Kinoma/Kinoma-Element-Open-source-hardware-1st-Generation/README.md

# Kinoma Element

This repository contains open source hardware resources for Kinoma Element.

The application framework software for Kinoma Element is in the [kinomajs](https://github.com/Kinoma/kinomajs) repository .

Including:

* BOM
* PCB Design files
* PCB Schematics
* STEP files for case
