Kinoma/Kinoma-Element-Open-source-hardware-1st-Generation/bom/Element-dvt-Nov30.xlsx

Kinoma Element Revised: Wednesday, November 25, 2015
Kinoma Element DVT2 Revision: 1
Bill Of Materials November 25,2015 13:31:08
Item | Quantity | Reference | Part | Vendor | Part Number | Description | Notes
______________________________________________
1 | 1 | ANT1 | 2450AT18A100 | johanson | 2450AT18A100 | Chip Antenna 3.2 x 1.6 x 1.3mm | DO NOT SUBSTITUTE
2 | 1 | CM1 | CMC_2L_60R_600mA | Wurth | 7442335600 | CHOKE COM MODE 60R,600mA | DO NOT SUBSTITUTE
3 | 1 | CM2 | CMC_3L | TDK | ACM2520-801-3P-T002 | CHOKE COMMON MODE 800 OHM SMD | DO NOT SUBSTITUTE
4 | 5 | C1,C2,C16,C85,C90 | 2.2uF | TDK | C1005X5R1A225K050BC | CAP CER 2.2UF 10V 10% X5R 0402
5 | 21 | C3,C6,C7,C8,C9,C10,C13,C14,C24,C27,C28,C29,C48,C86,C87,C88,C89,C92,C93,C94,C96 | 0.1uF | murata | GRM033R60J104KE19D | CAP CER 0.1UF 6.3V 10% X5R 0201
6 | 8 | C4,C19,C21,C22,C23,C25,C26,C98 | 0.01uF | murata | GRM033R71A103KA01D | CAP CER 10000PF 10V 10% X7R 0201
7 | 3 | C5,C15,C17 | 10uF 6.3V X5R | tdk | C1005X5R0J106M050BC | CAP CER 10UF 6.3V 20% X5R 0402
8 | 1 | C12 | 10pF RF | johanson | 250R05L100GV4T | CAP CER 10PF 25V 2% NP0 0201 | DO NOT SUBSTITUTE
9 | 2 | C18,C20 | 1.0uF | tdk | C0603X5R0J105M030BC | CAP CER 1UF 6.3V 20% X5R 0201
10 | 1 | C49 | 10uF 10V X6S | murata | GRM188C81A106MA73D | CAP CER 10UF 10V 20% X6S 0603
11 | 1 | C50 | 4.7uF | Taiyo | LMK107BJ475KA-T | CAP CER 4.7UF 10V 10% X5R 0603
12 | 1 | C51 | 10uF 6.3V X5R | tdk | C1608X5R0J106K080AB | CAP CER 10UF 6.3V 10% X5R 0603
13 | 1 | D10 | DIODE_LED_RGB_RA | sunled | XZMDKDGCBD56W | LED 3.0X1.0MM RGB WTR CLR RA SMD
14 | 6 | FB1,FB2,FB7,FB8,FB9,FB10 | FB/3A | Wurth Electronics | 742792602 | WE-CBF SMD EMI SUPP FERRITE BEAD
15 | 1 | FL1 | LFB182G45CL3D178 | murata | LFB182G45CL3D178 | FILTER BANDPASS 2.4 GHZ | DO NOT SUBSTITUTE
16 | 1 | J1 | CON8A | sullin | GRPB042VWQP-RC | CONN HEADER .050" 8POS DL SMD AU | For development use ONLY
17 | 1 | J3 | USB MICRO-AB RCPT | molex | 475901001 | Connector Receptacle USB micro AB 5 Position Surface Mount, Right Angle, Horizontal
 |  |  |  | Hirose | ZX62RD-AB-5P8 | possible substitutes for line # 17
18 | 2 | J6,J9 | HDR1x8 | Gradconn | BB02-JS082.-K03-000000 | Connector Header 8 Position 0.100" (2.54mm) Tin SMD, Right Angle
19 | 2 | L1,L5 | 2.2nH | Johanson | L-07C2N2SV6T | FIXED IND 2.2NH 300MA 160 MOHM | DO NOT SUBSTITUTE
20 | 1 | L3 | 2.2uH | taiyo | BRC2012T2R2MD | FIXED IND 2.2UH 1A 143 MOHM SMD
21 | 1 | L4 | 2.2uH | sumida | CDRH2D14NP-2R2NC | FIXED IND 2.2UH 1.6A 94 MOHM SMD
22 | 2 | MOV1,MOV3 | CDS305GTA | Epcos | B72500D50A60 | VARISTOR 6.4V 30A 0603
 |  |  |  | Wurth | 82536040 | possible substitutes for line # 22,
 |  |  |  | Bourns | CG0603MLA-5.5ME
 |  |  |  | Eaton | MLVA06V05C270
23 | 16 | Q1,Q2,Q3,Q4,Q5,Q6,Q7,Q8,Q9,Q10,Q11,Q12,Q13,Q14,Q15,Q16 | FDY4000CZ | Fairchild | FDY4000CZ | MOSFET N/P-CH 20V SC89-6 | DO NOT SUBSTITUTE
24 | 1 | R3 | 6.04k 1% | panasonic | ERJ-1GEF6041C | RES SMD 6.04K OHM 1% 1/20W 0201
25 | 4 | R4,R5,R6,R7 | 51K | panasonic | ERJ-1GEJ513C | RES SMD 51K OHM 5% 1/20W 0201
26 | 1 | R25 | 1k | panasonic | ERJ-1GEJ102C | RES SMD 1K OHM 5% 1/20W 0201
27 | 41 | R27,R28,R29,R30,R36,R63,R84,R85,R86,R87,R88,R89,R90,R91,R92,R93,R94,R95,R96,R97,R98,R99,R100,R101,R102,R103,R104,R105,R106,R107,R108,R109,R110,R111,R112,R113,R114,R115,R116,R117,R121 | 10K | Panasonic | ERJ-1GEJ103C | RES 10K OHM 1/20W 5% 0201 SMD
28 | 3 | R48,R49,R118 | 330R | panasonic | ERJ-1GEJ331C | RES SMD 330 OHM 5% 1/20W 0201
29 | 1 | R54 | 2.2K | panasonic | ERJ-1GEJ222C | RES SMD 2.2K OHM 5% 1/20W 0201
30 | 1 | R60 | 0R | Panasonic | ERJ-3GEY0R00V | RES 0.0 OHM 1/10W 0603 SMD
31 | 1 | R64 | 453K | Panasonic | ERJ-1GEF4533C | RES SMD 453K OHM 1% 1/20W 0201
32 | 1 | R65 | 100K | Panasonic | ERJ-1GEF1003C | RES SMD 100K OHM 1% 1/20W 0201
33 | 2 | R119,R120 | 100R | panasonic | ERJ-1GEJ101C | RES SMD 100 OHM 5% 1/20W 0201
34 | 1 | R128 | 22R | panasonic | ERJ-1GEF22R0C | RES SMD 22 OHM 1% 1/20W 0201
35 | 2 | S1,S2 | SW_PB_RA_4P | wurth | 434331045822 | SWITCH TACTILE SPST-NO 0.05A 12V | consigned
36 | 1 | U1 | 88MW302QFN88 | marvell | 88MW302QFN88 | IC MRVL 88MW302 WLAN MICROCONTROLLER SoC QFN88L 0.4mm 10x10x0.9mm | consigned
37 | 1 | U2 | W25Q32FVZPIG | winbond | W25Q32FVZPIG | IC SPI SRL FLASH DUAL/QUAD I/O 32M 2.7-3.6V 104MHZ WSON-8 6x5x0.8mm | DO NOT SUBSTITUTE
38 | 1 | U7 | AP3417C | Diodes | AP3417CKTR-G1 | IC REG BUCK SYNC ADJ 1A SOT25
39 | 1 | U8 | IP4220CZ6 | nxp | IP4220CZ6,125 | IC USB DUAL ESD PROTECT 6TSOP | DO NOT SUBSTITUTE
40 | 4 | U13,U14,U17,U18 | 74HC4094 | NXP | 74HC4094PW,118 | IC 8STAGE SHFT/STORE BUS 16TSSOP
 |  |  |  | TI | CD4094BPWR | Possble substitutes for line # 40
 |  |  |  | Rohm | BU4094BCFV-E2
 |  |  |  | On Semiconductor | MC14094BDTR2G
 |  |  |  | ST microelectronics | M74HC4094TTR
41 | 4 | U15,U16,U19,U20 | D5V0F4U6SO-7 | Diodes | D5V0F4U6SO-7 | TVS DIODE 5.5VWM 12VC SOT26
42 | 1 | Y1 | 38.4MHz +/-10ppm | txc | 8Q38470003 | Crystal 38.4000MHz 10ppm 8pF 80 Ohm -20°C - 70°C Surface Mount 4-SMD, No Lead (DFN, LCC) | DO NOT SUBSTITUTE
43 | 1 | Y2 | 32.768KHz_3.3V_+/-25ppm | txc | 7XZ3270018 | OSC XO 32.768KHZ CMOS SMD | DO NOT SUBSTITUTE
Unpopulated Parts
44 | 2 | C84,C91 | *2.2uF | TDK | C1005X5R1A225K | CAP CER 2.2UF 10V 10% X5R 0402
45 | 1 | C95 | *0.1uF | murata | GRM033R60J104KE19D | CAP CER 0.1UF 6.3V 10% X5R 0201
46 | 1 | J2 | *3PIN | fci | 68000-103HLF | BERGSTIK II .100" SR STRAIGHT
47 | 1 | J11 | *CON2 | sullin | GRPB021VWVN-RC | CONN HEADER .050" 2POS PCB GOLD
48 | 1 | L2 | *2.2nH | Johanson | L-07C2N2SV6T | FIXED IND 2.2NH 300MA 160 MOHM
49 | 7 | TP1,TP2,TP3,TP4,TP5,TP6,TP7 | *T_POINT | Test | NA | SMT Test Point
