Kinoma/Kinoma-Element-Open-source-hardware-1st-Generation/sch/element-dvt-Nov30.pdf

# 2.4GHz Wifi Antenna

# GPIO

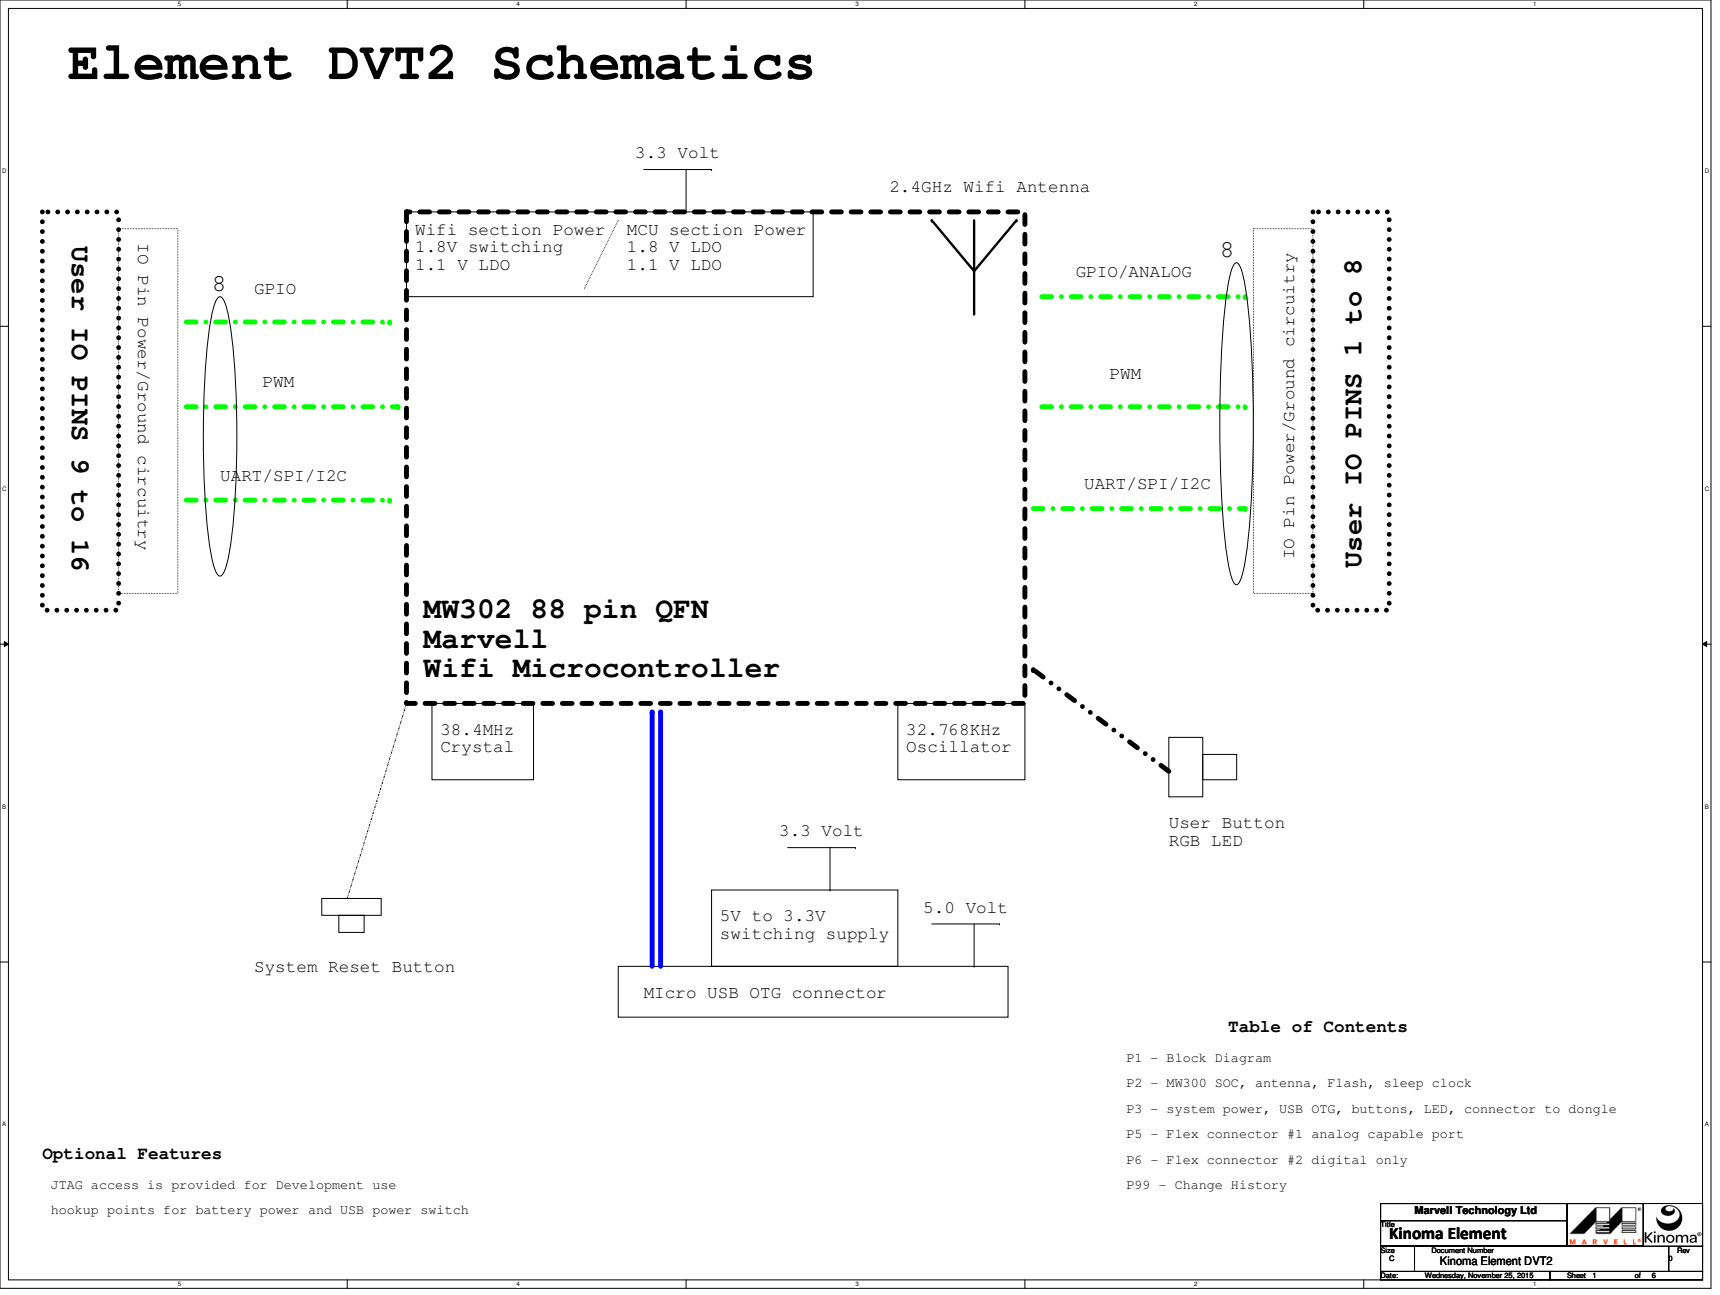
[picture p2: page 1]
P1 - Block Diagram; Optional Features; P6 - Flex connector #2 digital only; P99 - Change History; 5V to 3.3V switching supply; 38.4MHz Crystal; 32.768KHz Oscillator; 3.3 Volt; User Button RGB LED; PWM; UART/SPI/I2C; GPIO/ANALOG; MW302 88 pin QFN Marvell Wifi Microcontroller; 5.0 Volt; Element DVT2 Schematics; Title; Size; Document Number; Rev; Date:; Sheet; Kinoma Element DVT2; Wednesday, November 25, 2015; Kinoma Element

Wifi section Power
1.8V switching
1.1 V LDO

MCU section Power
1.8 V LDO

User IO PINS 9 to 16

IO Pin Power/Ground circuitry

User IO PINS 1 to 8

System Reset Button

MIcro USB OTG connector

Table of Contents

P2 - MW300 SOC, antenna, Flash, sleep clock

P3 - system power, USB OTG, buttons, LED, connector to dongle

P5 - Flex connector #1 analog capable port

JTAG access is provided for Development use

hookup points for battery power and USB power switch

Marvell Technology Ltd
Kinoma Element

# 88MW302 QFN-88 SoC Circuit

# STRAP1 not used

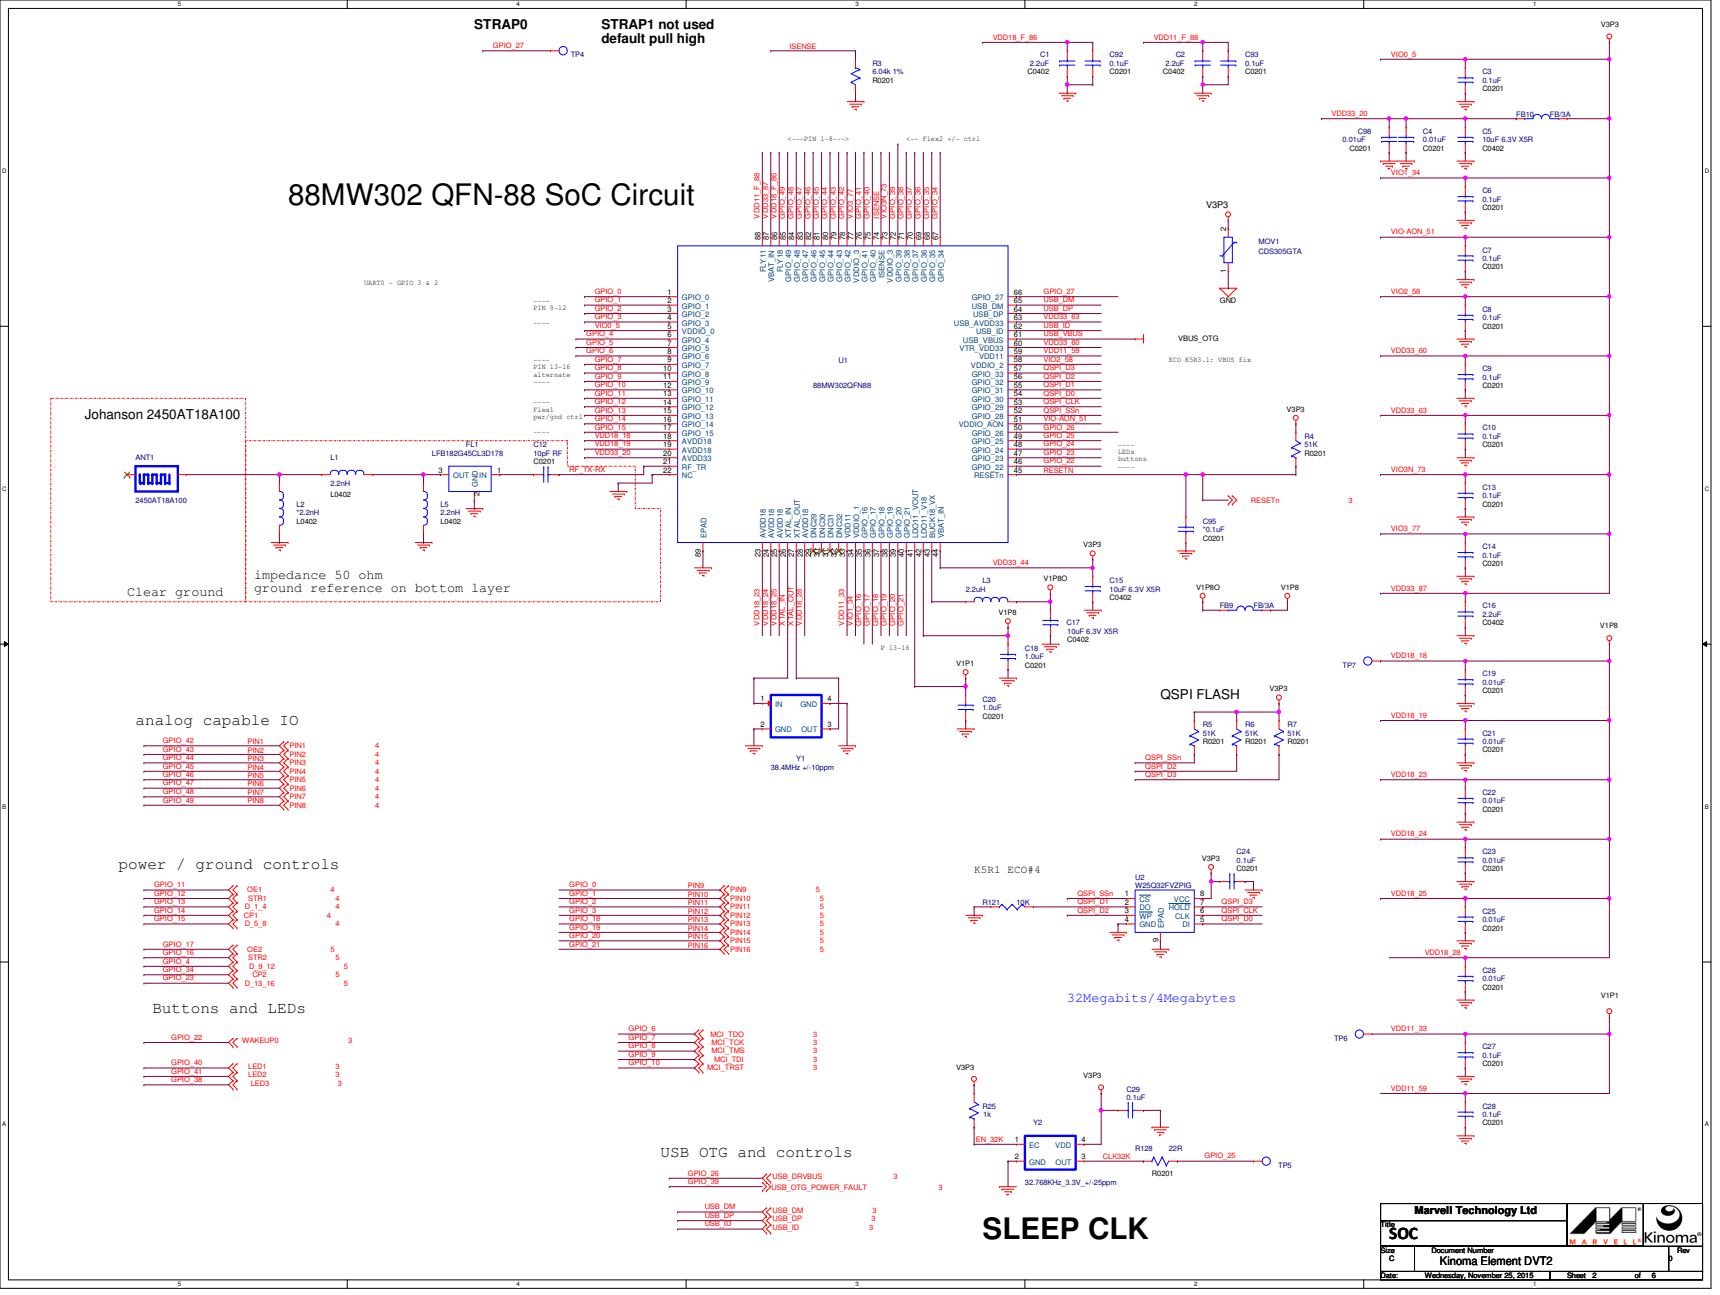
[picture p3: page 2]

impedance 50 ohm
ground reference on bottom layer

# FTDI, USB OTG JTAG on dongle for development

# Battery Hookup

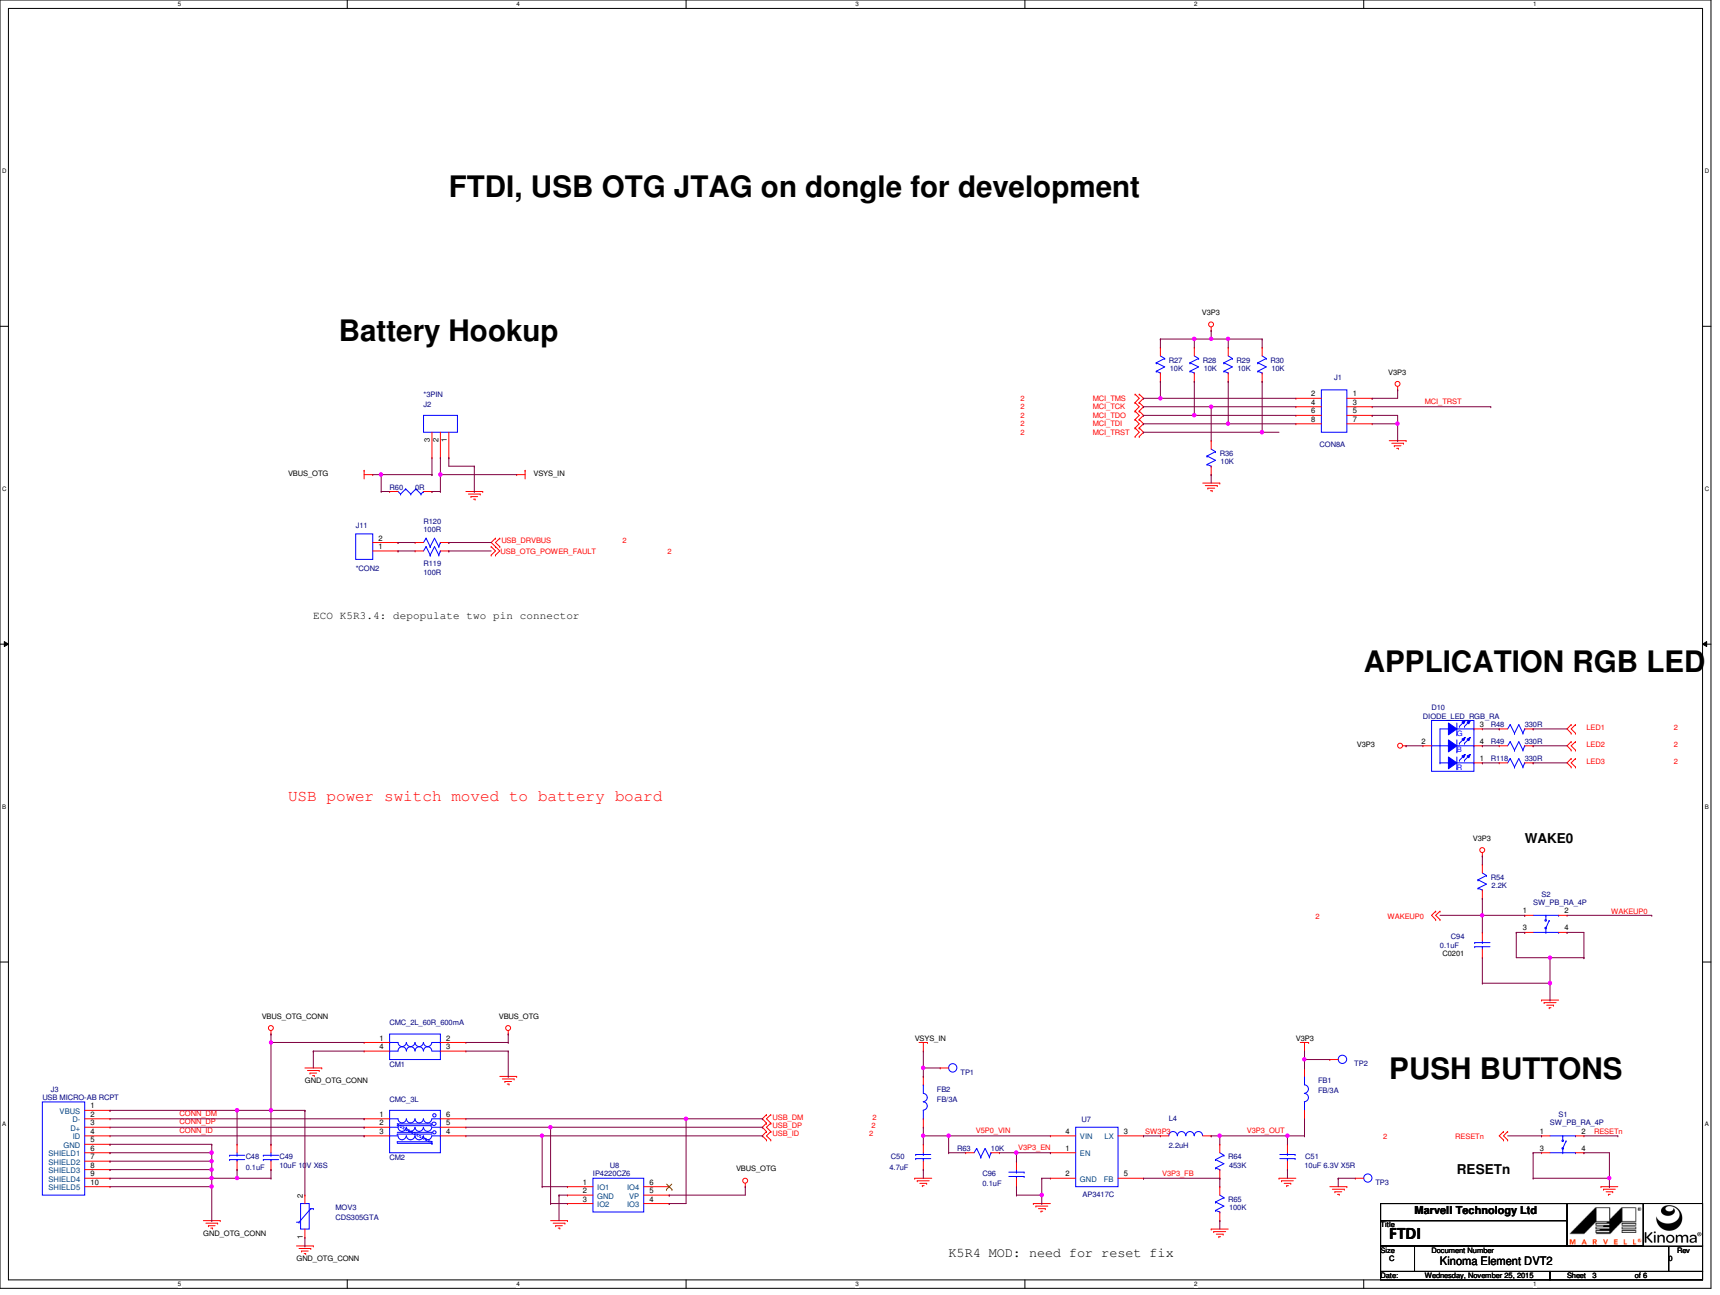
[picture p4: page 3]

ECO K5R3.4: depopulate two pin connector

USB power switch moved to battery board

USB MICRO-AB RCPT

K5R4 MOD: need for reset fix

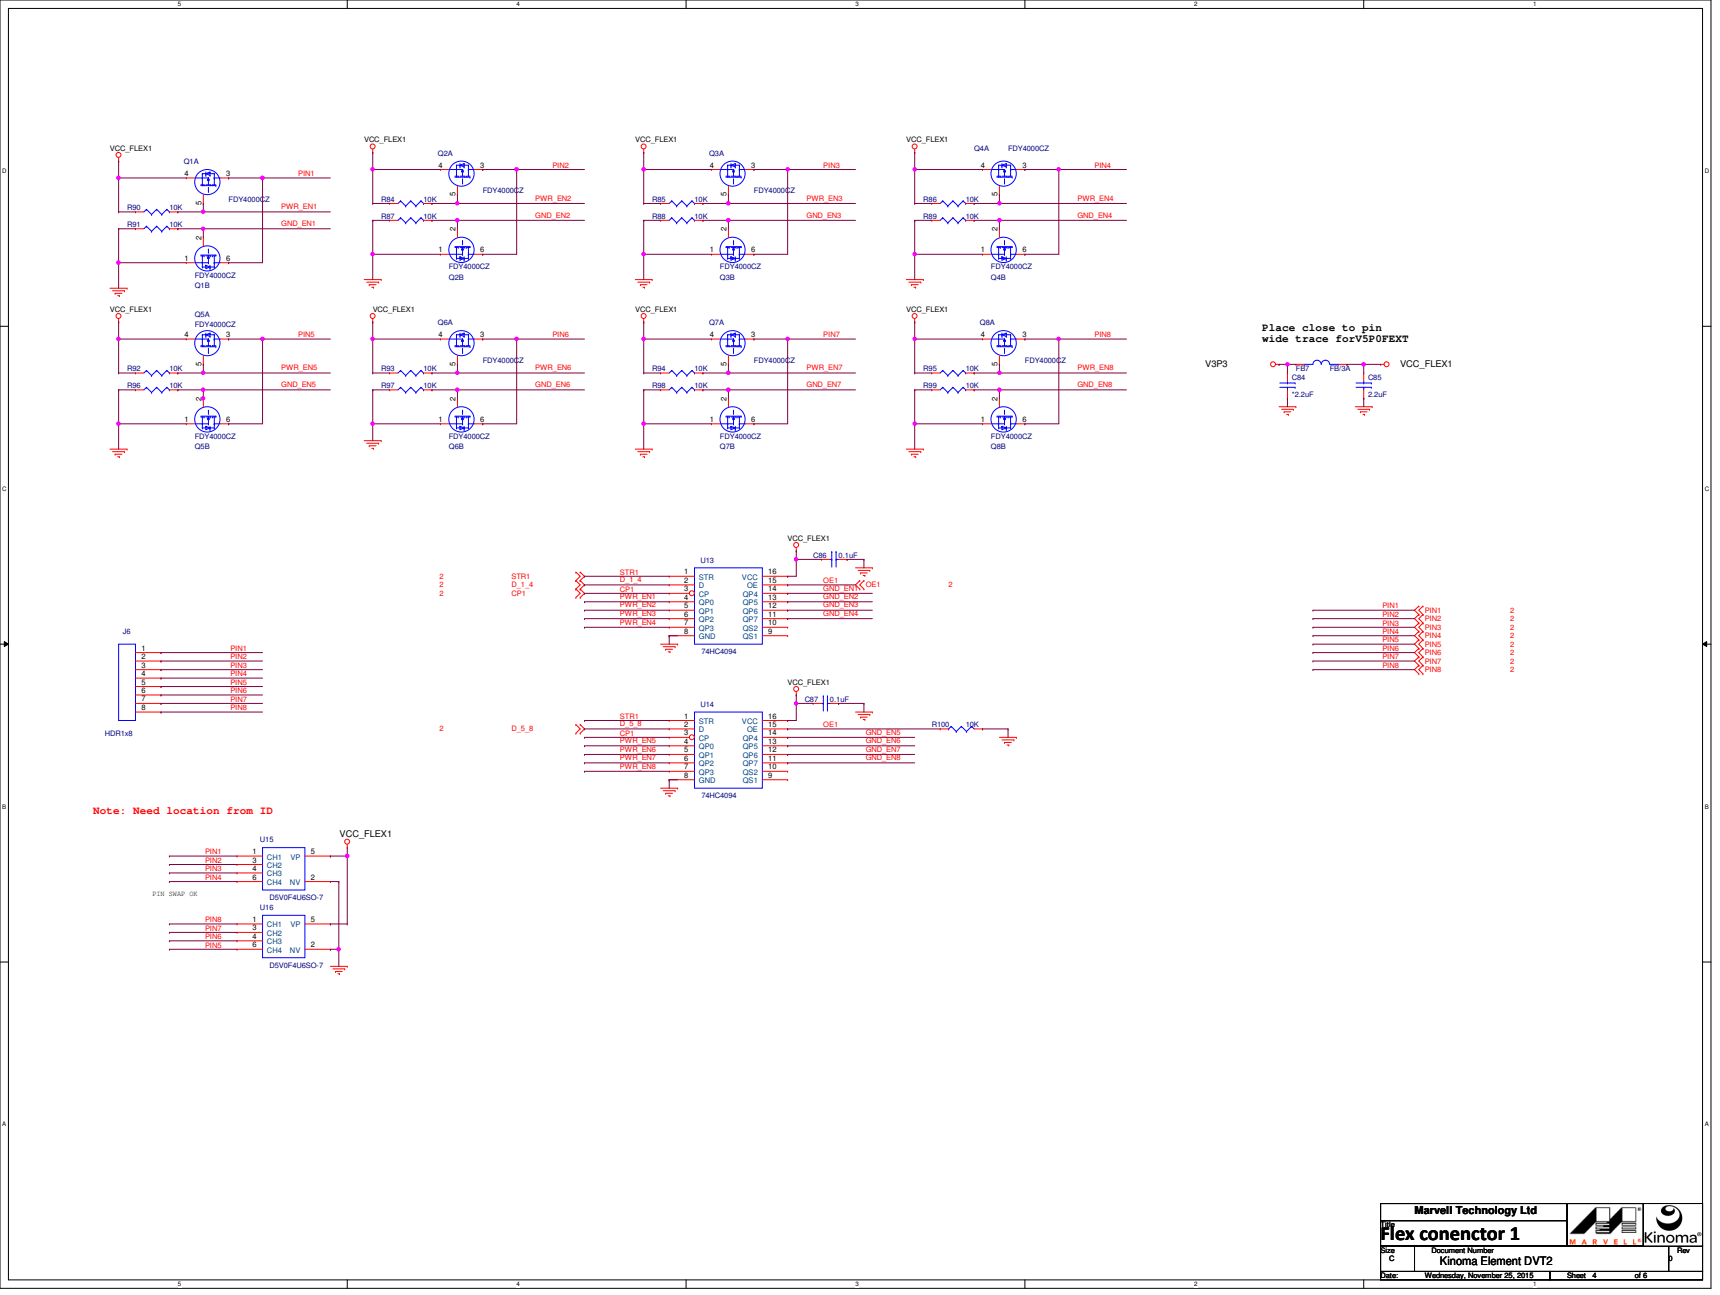
[picture p5: page 4]

Place close to pin
wide trace forV5P0FEXT

Note: Need location from ID

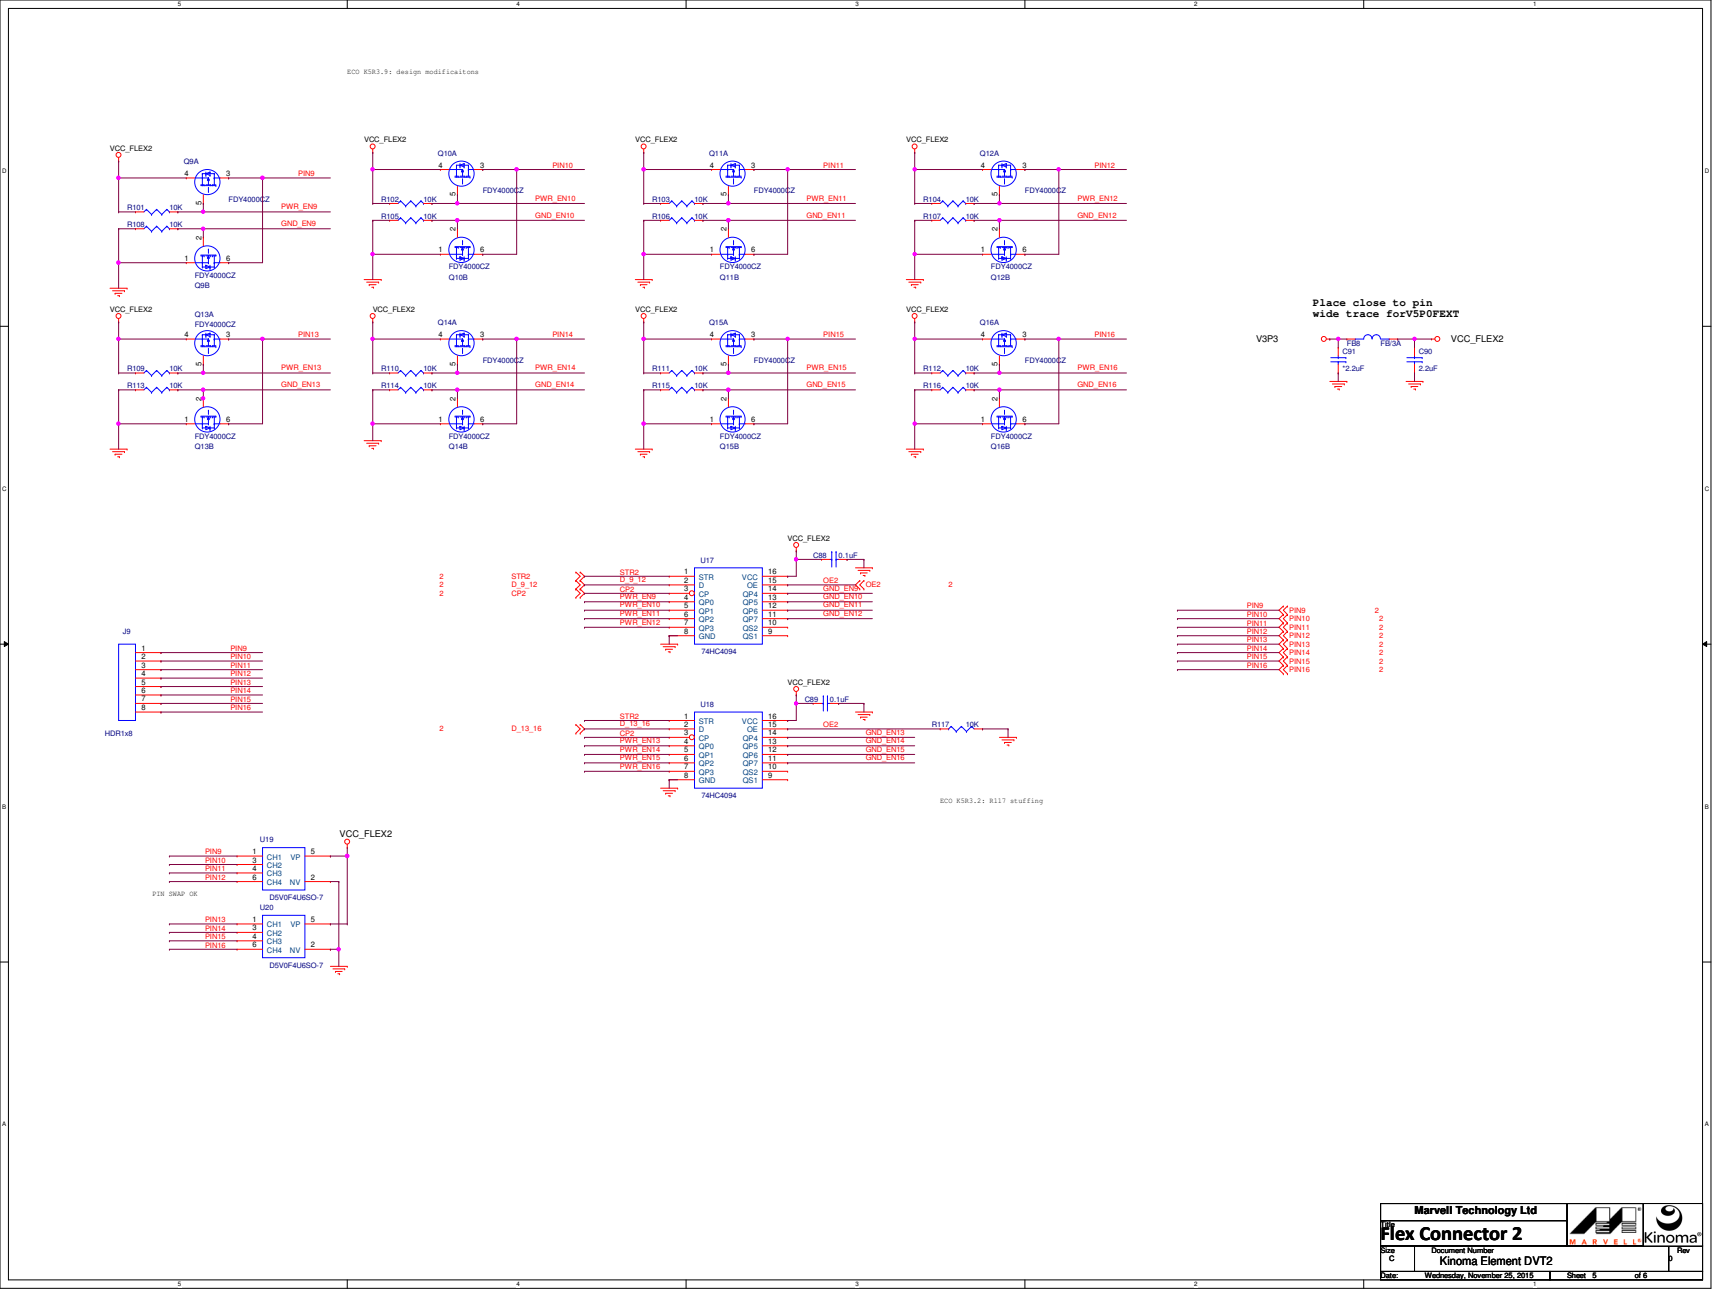
[picture p6: page 5]

Place close to pin
wide trace forV5P0FEXT

# Revision History

# K5R0 First Prototype

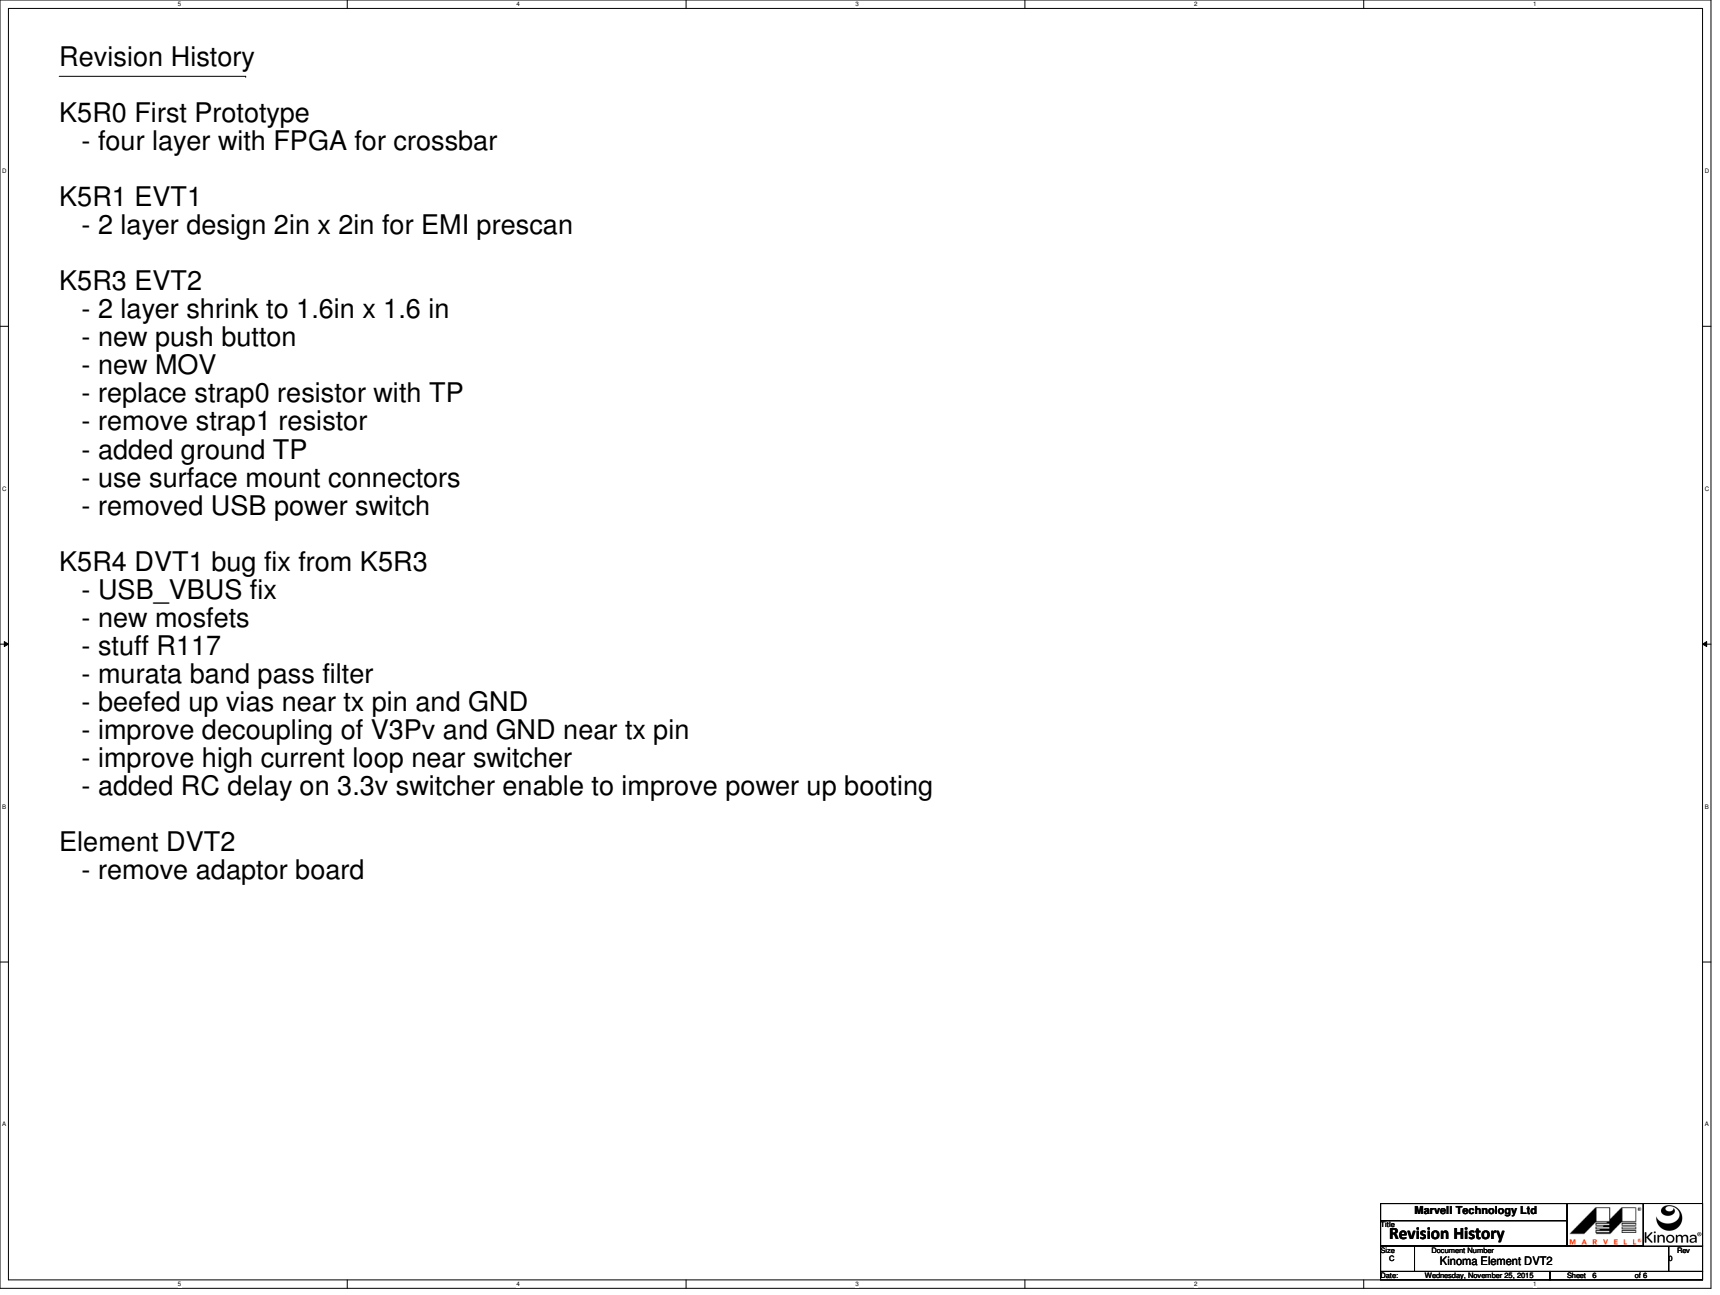
[picture p7: page 6]
Element DVT2 - remove adaptor board; Revision History; Wednesday, November 25, 2015

- four layer with FPGA for crossbar

K5R1 EVT1
- 2 layer design 2in x 2in for EMI prescan

K5R3 EVT2
- 2 layer shrink to 1.6in x 1.6 in
- new push button
- new MOV
- replace strap0 resistor with TP
- remove strap1 resistor
- added ground TP
- use surface mount connectors
- removed USB power switch

K5R4 DVT1 bug fix from K5R3
- USB_VBUS fix
- new mosfets
- stuff R117
- murata band pass filter
- beefed up vias near tx pin and GND
- improve decoupling of V3Pv and GND near tx pin
- improve high current loop near switcher
- added RC delay on 3.3v switcher enable to improve power up booting
