Kinoma/Kinoma-Element-Open-source-hardware-1st-Generation/(list of files, drawings)

Other design files:
sch/ELEMENT-DVT.DSN
sch/element-dvt.opj
