Kinoma/Kinoma-Element-Open-source-hardware-1st-Generation/(commit log)

2015-12-22 Hardware files
    [ELEMENT-DVT.DSN, Element-dvt-Nov30.xlsx, element-dvt.opj]
2015-12-22 2d case drawing
